cyranoF/ProjektarbeitBerlinerUhr/CaseUpper.3mf

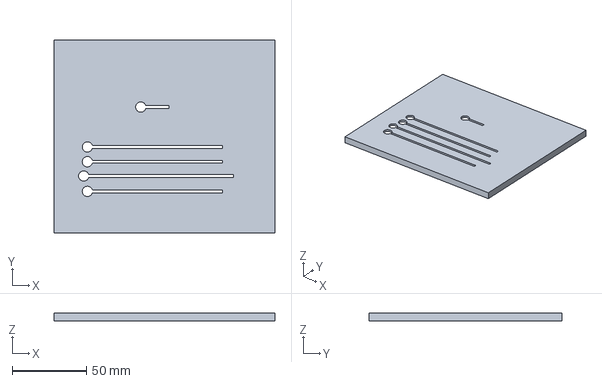
[picture p13: CAD file, 2023-07-12]
CaseUpper.3mf
149.2 x 130.2 x 5.60 mm
