cyranoF/ProjektarbeitBerlinerUhr/CaseUnder.3mf

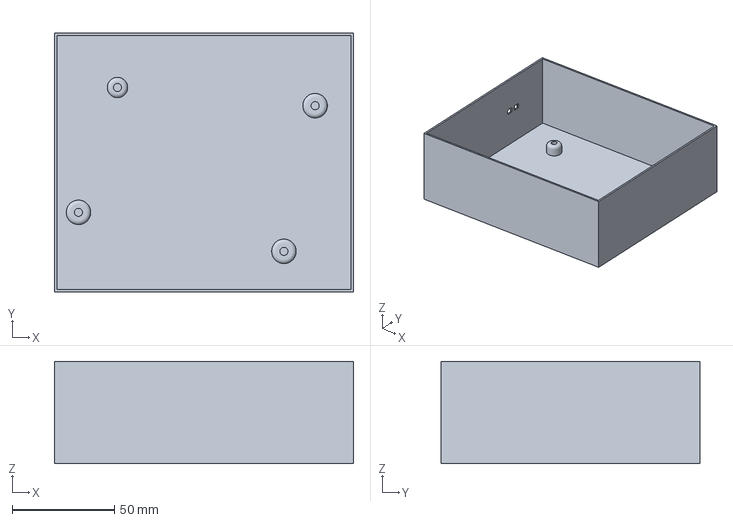
[picture p14: CAD file, 2023-07-12]
CaseUnder.3mf
146.0 x 126.6 x 50.0 mm
