cyranoF/ProjektarbeitBerlinerUhr/topDisplay.3mf

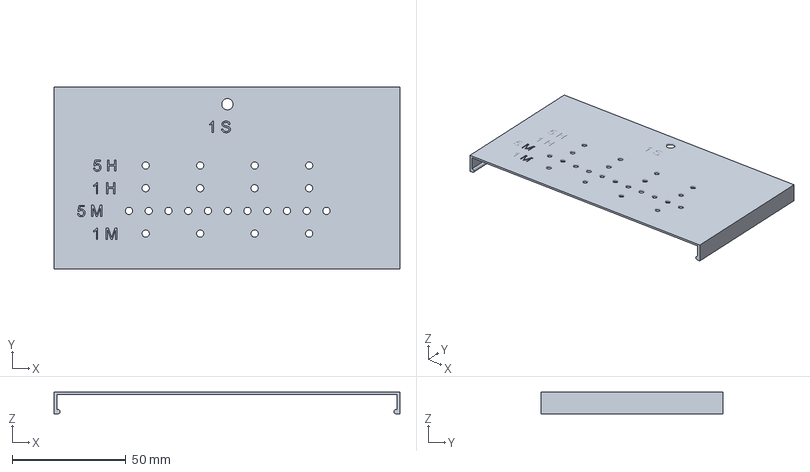
[picture p15: CAD file, 2023-07-12]
topDisplay.3mf
152.4 x 80.0 x 9.60 mm
