cyranoF/ProjektarbeitBerlinerUhr/berlinerUhrSCH.sch

## EAGLE design berlinerUhrSCH.sch (2023-07-12)

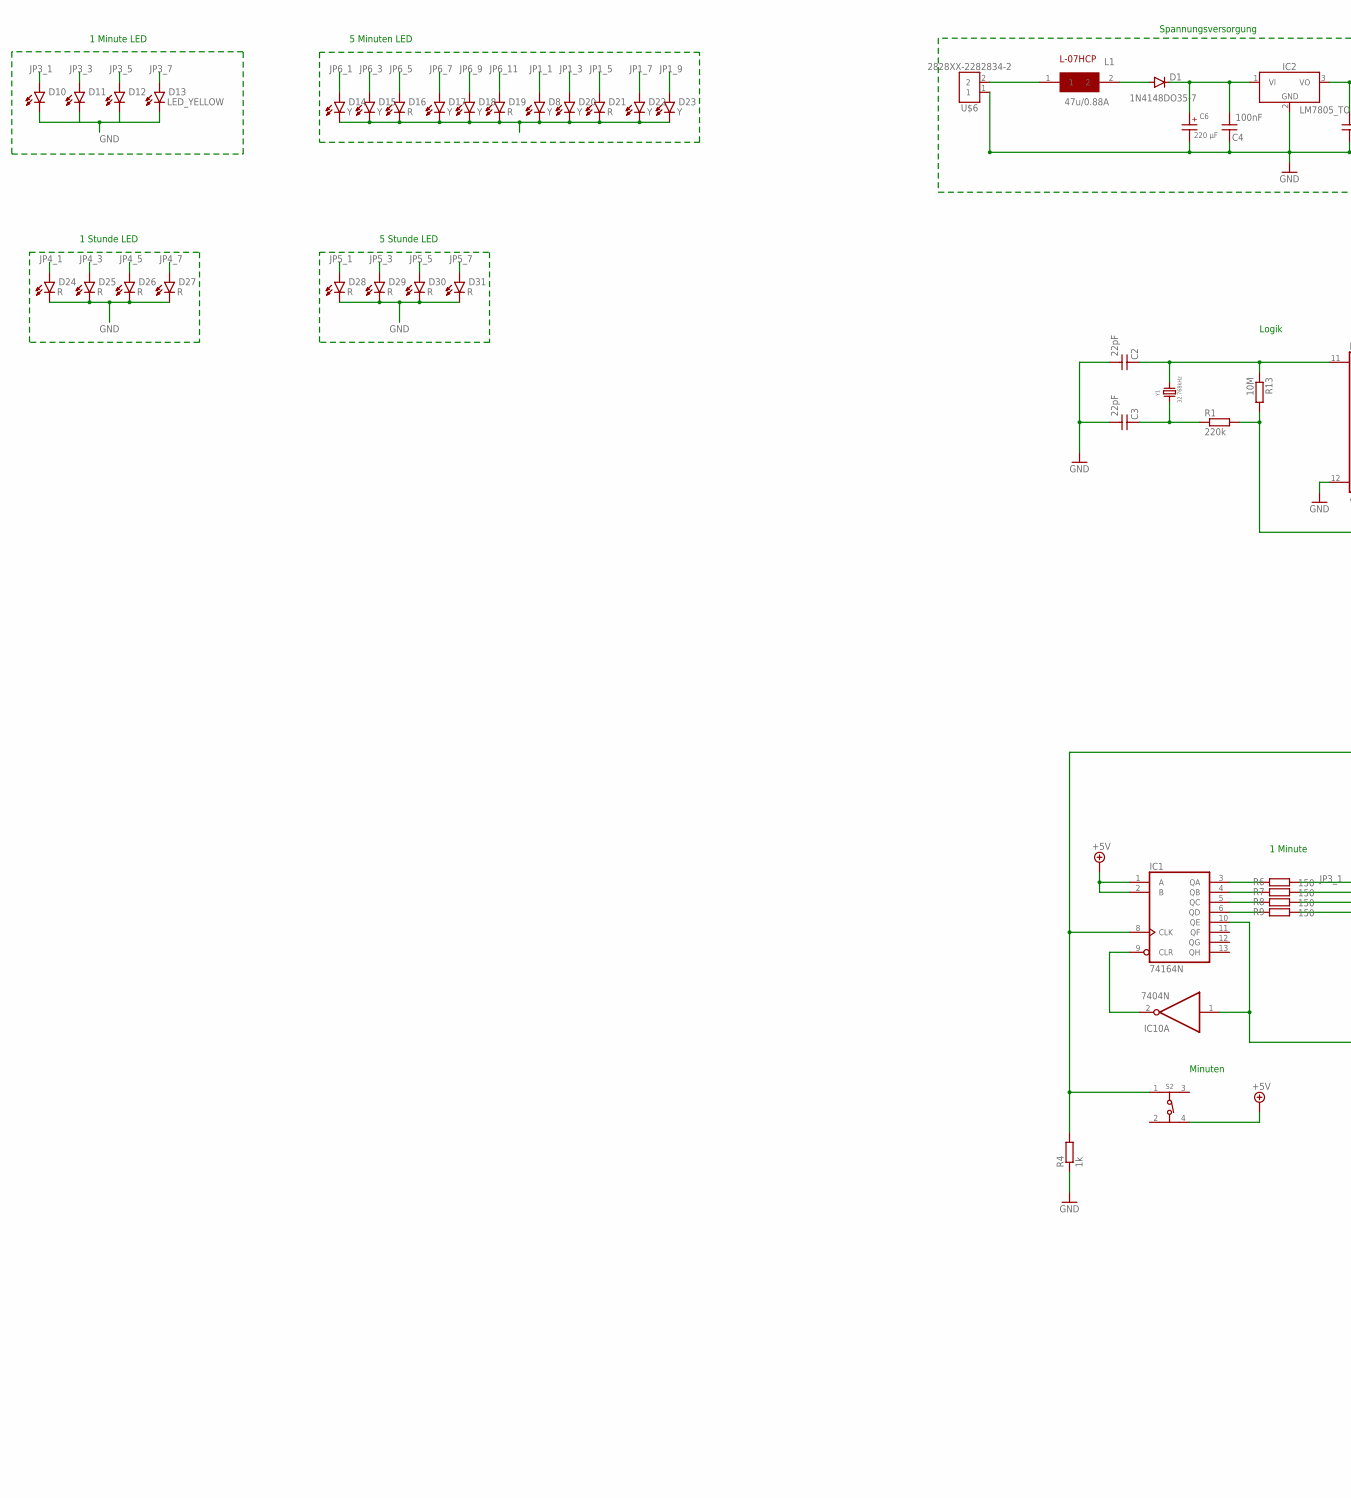
[picture p16: schematic berlinerUhrSCH.sch, part in row 1, column 1]

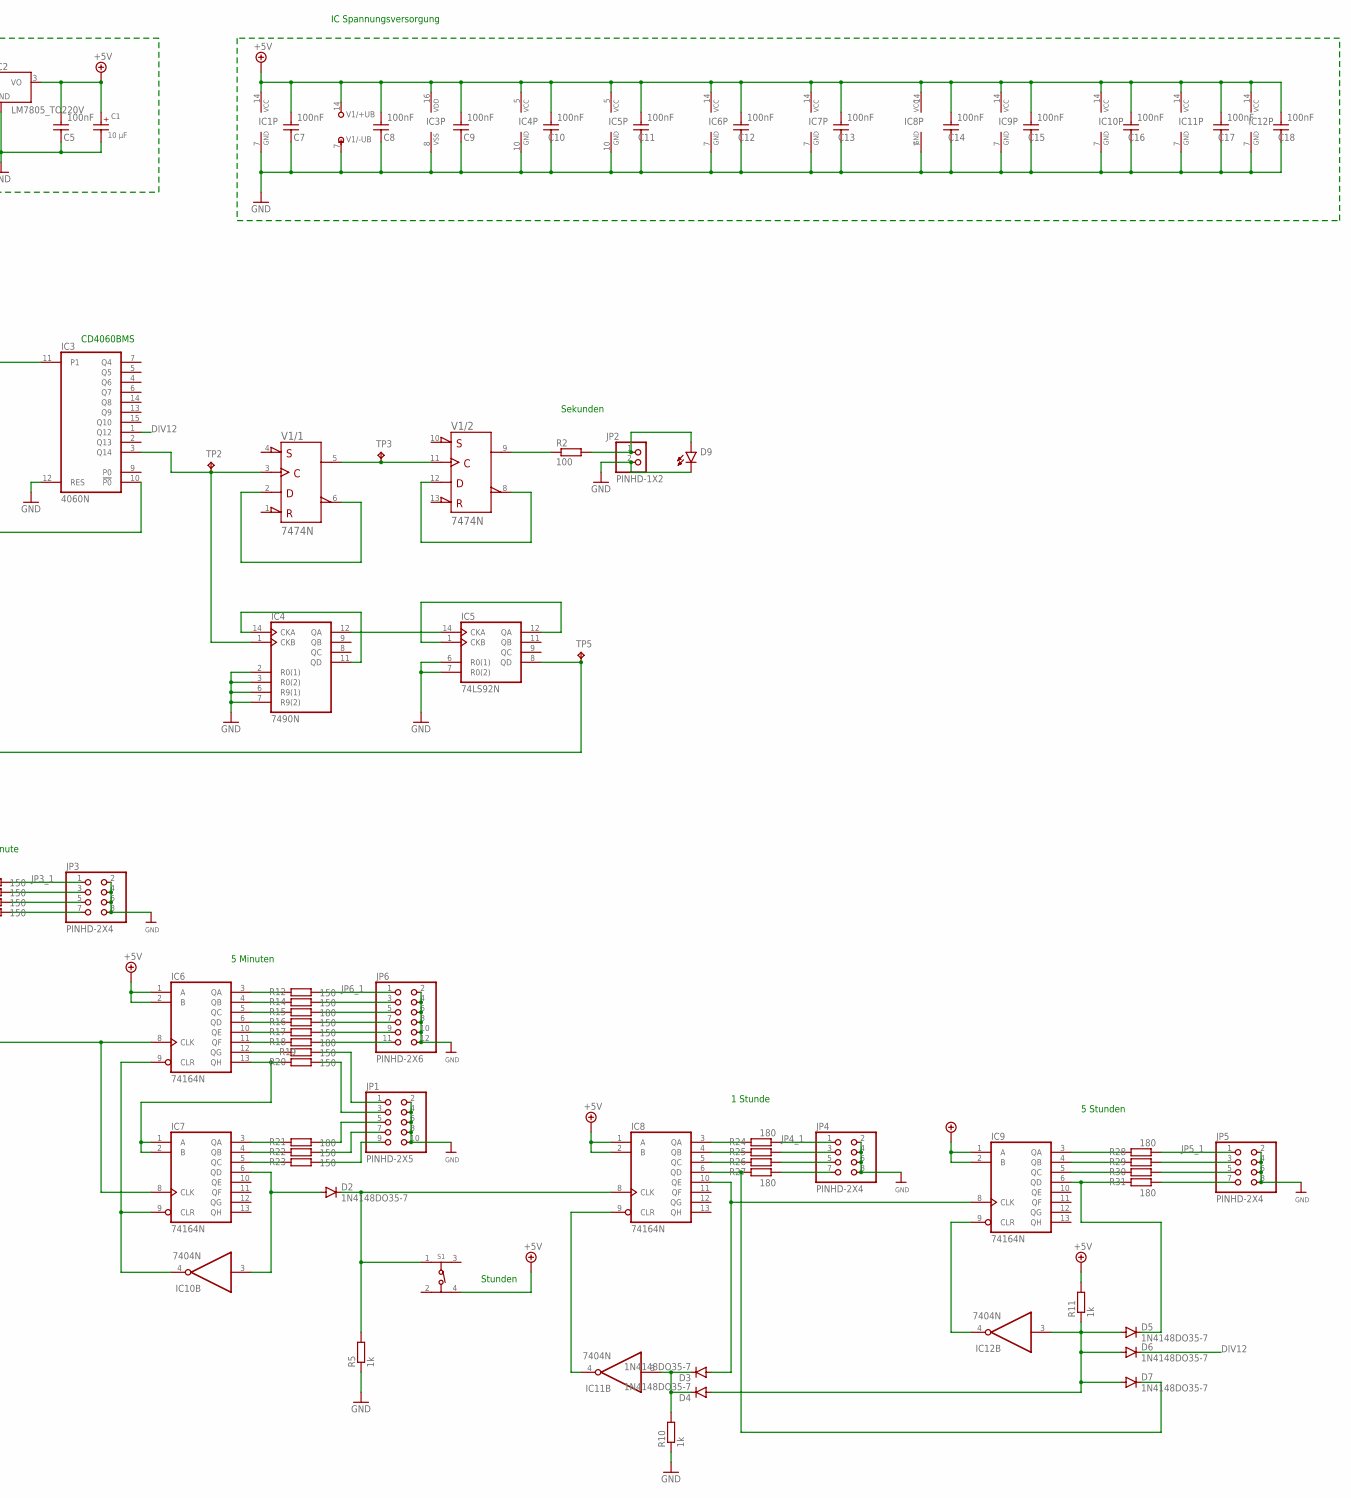
[picture p17: schematic berlinerUhrSCH.sch, part in row 1, column 2]

Parts:
C1: 10 µF; WCAP-ATG8_10X12.5(DXL)
C2, C3: 22pF; WCAP-CSGP_0805_H1.25_R
C4, C5, C7, C8, C9, C10, C11, C12, C13, C14, C15, C16, C17, C18: 100nF; WCAP-CSGP_0805_H1.25_R
C6: 220 µF; WCAP-ATG8_10X12.5(DXL)
D1, D2, D3, D4, D5, D6, D7: 1N4148DO35-7; DO35-7
D8, D14, D15, D17, D18, D20, D22, D23: Y; LEDRD254W60D565H860B_Y
D9, D10, D11, D12, D13: LED_YELLOW; LEDRD254W60D565H860B_Y
D16, D19, D21, D24, D25, D26, D27, D28, D29, D30, D31: R; LEDRD254W60D565H860B
IC1, IC6, IC7, IC8, IC9: 74164N; DIL14
IC2: LM7805_TO220V; TO220V
IC3: 4060N; DIL16
IC4: 7490N; DIL14
IC5: 74LS92N; DIL14
IC10, IC11, IC12: 7404N; DIL14
JP1: PINHD-2X5; 2X05
JP2: PINHD-1X2; 1X02
JP3, JP4, JP5: PINHD-2X4; 2X04
JP6: PINHD-2X6; 2X06
L1: 47u/0.88A; L-07HCP
R1: 220k; RESC3216X70
R2: 100; RESC3216X70
R4, R5, R10, R11: 1k; RESC3216X70
R6, R7, R8, R9, R12, R14, R16, R17, R19, R20, R22, R23: 150; RESC3216X70
R13: 10M; RESC3216X70
R15, R18, R21, R24, R25, R26, R27, R28, R29, R30, R31: 180; RESC3216X70
S1, S2: 430156070736; 4301X60707X6
TP2, TP3, TP5: TPB1,27; B1,27
U$6: 2828XX-2282834-2; TERMBLK_254-2N
V1: 7474N; DIL14
Y1: 32.768kHz; WE-XTAL_CFPX-56

Connections:
1S: D9.1 (A), JP2.1, R2.2
+5V: C1.1 (+), C5.2, C7.2, C8.2, C9.2, C10.2, C11.2, C12.2, C13.2, C14.2, C15.2, C16.2, C17.2, C18.2, IC1.1 (A), IC1.2 (B), IC1.14 (VCC), IC2.3 (VO), IC3.16 (VDD), IC4.5 (VCC), IC5.5 (VCC), IC6.1 (A), IC6.2 (B), IC6.14 (VCC), IC7.14 (VCC), IC8.1 (A), IC8.2 (B), IC8.14 (VCC), IC9.1 (A), IC9.2 (B), IC9.14 (VCC), IC10.14 (VCC), IC11.14 (VCC), IC12.14 (VCC), R11.2, S1.4, S2.4, V1.14 (+UB)
DIV12: D6.C, IC3.1 (Q12)
GND: C1.2 (-), C2.2, C3.2, C4.1, C5.1, C6.2 (-), C7.1, C8.1, C9.1, C10.1, C11.1, C12.1, C13.1, C14.1, C15.1, C16.1, C17.1, C18.1, D9.2 (C), D10.2 (C), D13.2 (C), D24.2 (C), D25.2 (C), D26.2 (C), D27.2 (C), D28.2 (C), D29.2 (C), D30.2 (C), D31.2 (C), IC1.7 (GND), IC2.2 (GND), IC3.8 (VSS), IC3.12 (RES), IC4.2 (R0(1)), IC4.3 (R0(2)), IC4.6 (R9(1)), IC4.7 (R9(2)), IC4.10 (GND), IC5.6 (R0(1)), IC5.7 (R0(2)), IC5.10 (GND), IC6.7 (GND), IC7.7 (GND), IC8.7 (GND), IC9.7 (GND), IC10.7 (GND), IC11.7 (GND), IC12.7 (GND), JP1.2, JP1.4, JP1.6, JP1.8, JP1.10, JP2.2, JP3.2, JP3.4, JP3.6, JP3.8, JP4.2, JP4.4, JP4.6, JP4.8, JP5.2, JP5.4, JP5.6, JP5.8, JP6.2, JP6.4, JP6.6, JP6.8, JP6.10, JP6.12, R4.1, R5.1, R10.1, U$6.1, V1.7 (-UB)
JP1_1: D8.1 (A), JP1.1, R19.1
JP1_3: D20.1 (A), JP1.3, R20.1
JP1_5: D21.1 (A), JP1.5, R21.1
JP1_7: D22.1 (A), JP1.7, R22.1
JP1_9: D23.1 (A), JP1.9, R23.1
JP3_1: D10.1 (A), JP3.1, R6.1
JP3_3: D11.1 (A), JP3.3, R7.1
JP3_5: D12.1 (A), JP3.5, R8.1
JP3_7: D13.1 (A), JP3.7, R9.1
JP4_1: D24.1 (A), JP4.1, R24.1
JP4_3: D25.1 (A), JP4.3, R25.1
JP4_5: D26.1 (A), JP4.5, R26.1
JP4_7: D27.1 (A), JP4.7, R27.1
JP5_1: D28.1 (A), JP5.1, R28.1
JP5_3: D29.1 (A), JP5.3, R29.1
JP5_5: D30.1 (A), JP5.5, R30.1
JP5_7: D31.1 (A), JP5.7, R31.1
JP6_1: D14.1 (A), JP6.1, R12.1
JP6_3: D15.1 (A), JP6.3, R14.1
JP6_5: D16.1 (A), JP6.5, R15.1
JP6_7: D17.1 (A), JP6.7, R16.1
JP6_9: D18.1 (A), JP6.9, R17.1
JP6_11: D19.1 (A), JP6.11, R18.1
unnamed: C4.2, C6.1 (+), D1.C, IC2.1 (VI)
unnamed: D1.A, L1.2
unnamed: C3.1, R1.1, Y1.1
unnamed: C2.1, IC3.11 (P1), R13.1, Y1.2
unnamed: IC3.10 (!P0), R1.2, R13.2
unnamed: IC3.3 (Q14), IC4.1 (CKB), TP2.TP, V1.3 (CLK)
unnamed: TP3.TP, V1.5 (Q), V1.11 (CLK)
unnamed: V1.2 (D), V1.6 (!Q)
unnamed: V1.8 (!Q), V1.12 (D)
unnamed: R2.1, V1.9 (Q)
unnamed: IC4.11 (QD), IC4.14 (CKA)
unnamed: IC4.12 (QA), IC5.14 (CKA)
unnamed: IC5.1 (CKB), IC5.12 (QA)
unnamed: IC1.8 (CLK), IC5.8 (QD), R4.2, S2.1, TP5.TP
unnamed: IC1.3 (QA), R6.2
unnamed: IC6.13 (QH), IC7.1 (A), IC7.2 (B), R20.2
unnamed: IC1.10 (QE), IC6.8 (CLK), IC7.8 (CLK), IC10.1 (I)
unnamed: IC1.9 (CLR), IC10.2 (O)
unnamed: IC6.9 (CLR), IC7.9 (CLR), IC10.4 (O)
unnamed: IC8.9 (CLR), IC11.4 (O)
unnamed: IC8.3 (QA), R24.2
unnamed: D2.C, IC8.8 (CLK), R5.2, S1.1
unnamed: D3.A, IC8.10 (QE), IC9.8 (CLK)
unnamed: D4.A, D5.A, D6.A, D7.A, IC12.3 (I), R11.1
unnamed: IC9.9 (CLR), IC12.4 (O)
unnamed: D3.C, D4.C, IC11.3 (I), R10.2
unnamed: D8.2 (C), D14.2 (C), D15.2 (C), D16.2 (C), D17.2 (C), D18.2 (C), D19.2 (C), D20.2 (C), D21.2 (C), D22.2 (C), D23.2 (C)
unnamed: D7.C, IC8.6 (QD), R27.2
unnamed: IC1.4 (QB), R7.2
unnamed: IC1.5 (QC), R8.2
unnamed: IC1.6 (QD), R9.2
unnamed: IC6.3 (QA), R12.2
unnamed: L1.1, U$6.2
unnamed: IC6.4 (QB), R14.2
unnamed: IC6.5 (QC), R15.2
unnamed: IC6.6 (QD), R16.2
unnamed: IC6.10 (QE), R17.2
unnamed: IC6.11 (QF), R18.2
unnamed: IC6.12 (QG), R19.2
unnamed: IC7.4 (QB), R22.2
unnamed: IC7.3 (QA), R21.2
unnamed: IC7.5 (QC), R23.2
unnamed: D2.A, IC7.6 (QD), IC10.3 (I)
unnamed: IC8.4 (QB), R25.2
unnamed: IC8.5 (QC), R26.2
unnamed: IC9.3 (QA), R28.2
unnamed: IC9.4 (QB), R29.2
unnamed: IC9.5 (QC), R30.2
unnamed: D5.C, IC9.6 (QD), R31.2

Notes on the sheet:
Spannungsversorgung
Minuten
Stunden
5 Minuten
Sekunden
IC Spannungsversorgung
Logik
CD4060BMS
1 Stunde
5 Stunden
1 Minute LED
5 Minuten LED
1 Stunde LED
5 Stunde LED
1 Minute
