cyranoF/ProjektarbeitBerlinerUhr/(notices)

Notices in the files:
parts and their libraries:
Wurth_Capacitors_WCAP-CSGP: Copyright: Würth Elektronik
